Akashamulya24125/soil-moisture-sensor/Soil_Sensor_v1.csv

Reference | Qty | Value | DNP | Exclude from BOM | Exclude from Board | Exclude from Simulation | Exclude from Position Files | Footprint | Datasheet
C1 | 1 | 1nF |  |  |  |  | ${EXCLUDE_FROM_POS_FILES} | Capacitor_SMD:C_0805_2012Metric
C2,C4 | 2 | 100nF |  |  |  |  | ${EXCLUDE_FROM_POS_FILES} | Capacitor_SMD:C_0805_2012Metric
C3 | 1 | 10nF |  |  |  |  | ${EXCLUDE_FROM_POS_FILES} | Capacitor_SMD:C_0805_2012Metric
D1 | 1 | 1N4148 |  |  |  |  | ${EXCLUDE_FROM_POS_FILES} | Diode_SMD:D_SOD-123 | https://assets.nexperia.com/documents/data-sheet/1N4148_1N4448.pdf
J1 | 1 | Conn_01x03 |  |  |  |  | ${EXCLUDE_FROM_POS_FILES} | Connector_PinHeader_2.54mm:PinHeader_1x03_P2.54mm_Vertical
R1 | 1 | 1kΩ |  |  |  |  | ${EXCLUDE_FROM_POS_FILES} | Resistor_SMD:R_0805_2012Metric
R2,R3 | 2 | 10kΩ |  |  |  |  | ${EXCLUDE_FROM_POS_FILES} | Resistor_SMD:R_0805_2012Metric
R4 | 1 | 100kΩ |  |  |  |  | ${EXCLUDE_FROM_POS_FILES} | Resistor_SMD:R_0805_2012Metric
U1 | 1 | NE555P |  |  |  |  | ${EXCLUDE_FROM_POS_FILES} | Package_DIP:DIP-8_W7.62mm | http://www.ti.com/lit/ds/symlink/ne555.pdf
