Akashamulya24125/soil-moisture-sensor/plots/Soil_Sensor_v1__Assembly.pdf

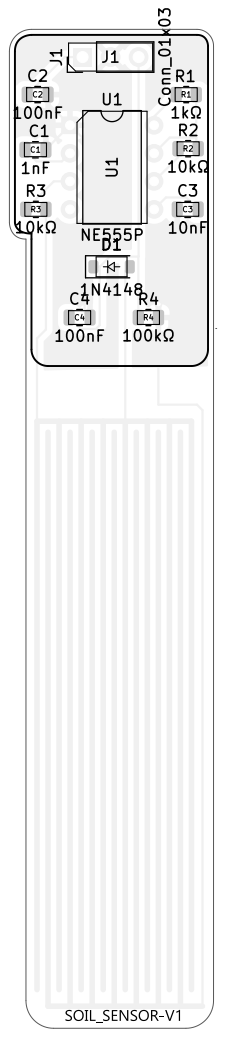
[picture p1: page 1]

Board2Pdf: Black And White TOP - Page 1/8

Sheet: Black And White TOP
File: Soil_Sensor_v1.kicad_pcb
Title:
KiCad E.D.A. 10.0.6

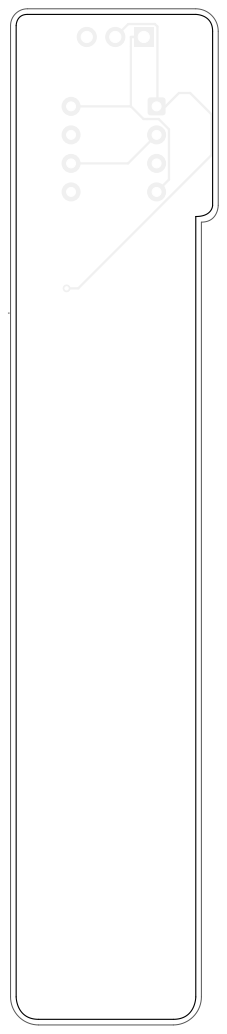
[picture p2: page 2]
D Date:

Board2Pdf: Black And White BOT - Page 2/8

Sheet: Black And White BOT
File: Soil_Sensor_v1.kicad_pcb
Title:

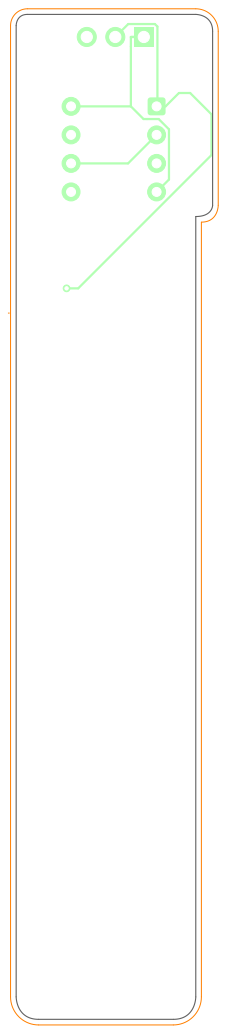
[picture p3: page 3]
D Date:

Board2Pdf: Colored BOT - Page 3/8

Sheet: Colored BOT
File: Soil_Sensor_v1.kicad_pcb
Title:

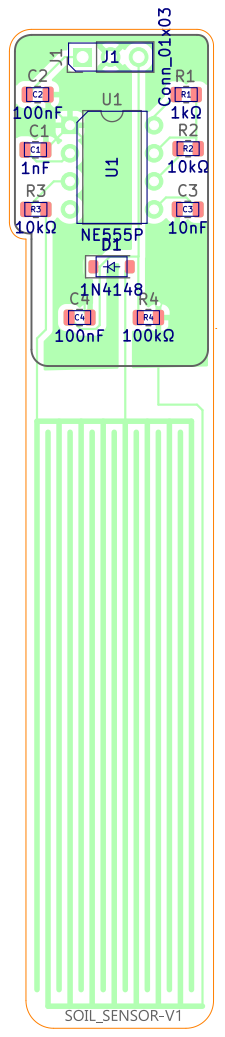
[picture p4: page 4]

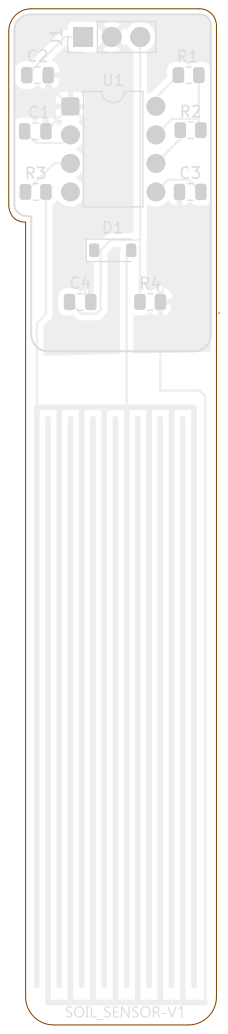
[picture p5: page 5]

Board2Pdf: Light Colors PCB Fabrication TOP - Page 5/8

Sheet: Light Colors PCB Fabrication TOP
File: Soil_Sensor_v1.kicad_pcb
Title:

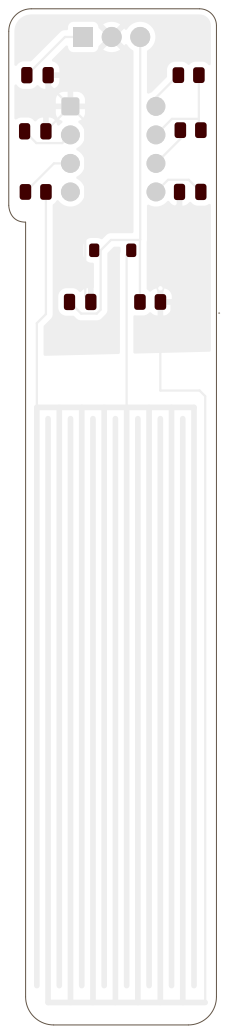
[picture p6: page 6]
D Date:

Board2Pdf: Light Colors PCB Paste TOP - Page 6/8

Sheet: Light Colors PCB Paste TOP
File: Soil_Sensor_v1.kicad_pcb
Title:

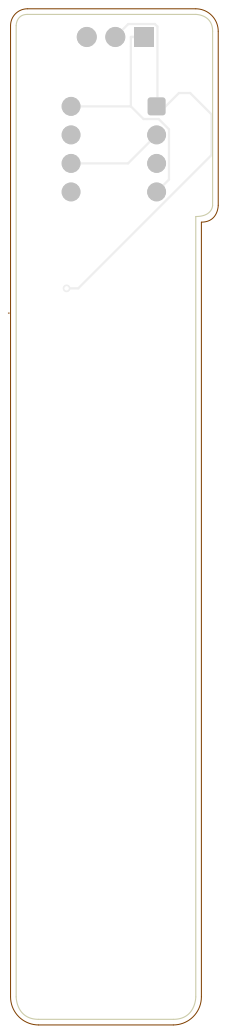
[picture p7: page 7]
D Date:

Board2Pdf: Light Colors Placement BOT - Page 7/8

Sheet: Light Colors Placement BOT
File: Soil_Sensor_v1.kicad_pcb
Title:

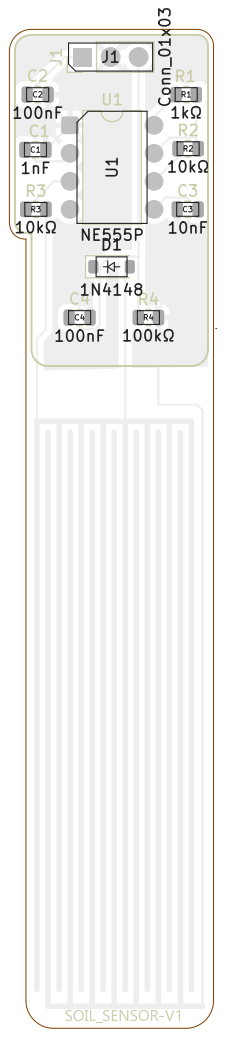
[picture p8: page 8]

Board2Pdf: Light Colors Placement TOP - Page 8/8

Sheet: Light Colors Placement TOP
File: Soil_Sensor_v1.kicad_pcb
Title:
