Akashamulya24125/soil-moisture-sensor/Soil_Sensor_v1.kicad_pcb

## KiCad design Soil_Sensor_v1.kicad_pcb (2026-10-20)

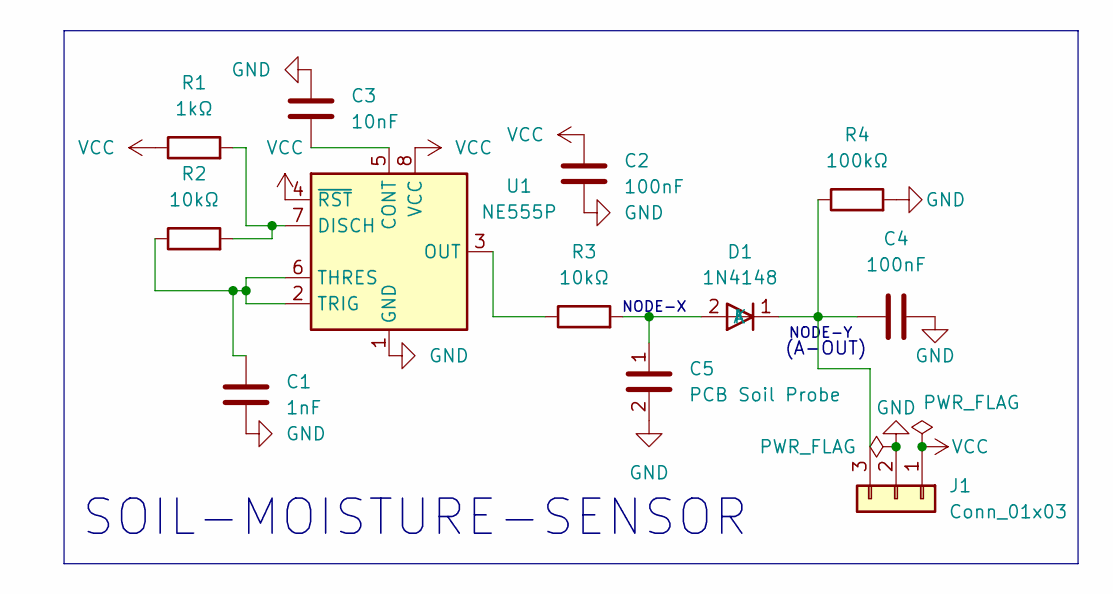
[picture p9: schematic Soil_Sensor_v1.kicad_sch, SOIL-SENSOR-VERSION-1]

Parts:
C1: 1nF; C_0805_2012Metric
C2, C4: 100nF; C_0805_2012Metric
C3: 10nF; C_0805_2012Metric
C5: PCB Soil Probe
D1: 1N4148; D_SOD-123
J1: Conn_01x03; PinHeader_1x03_P2.54mm_Vertical
R1: 1kΩ; R_0805_2012Metric
R2, R3: 10kΩ; R_0805_2012Metric
R4: 100kΩ; R_0805_2012Metric
U1: NE555P; DIP-8_W7.62mm

Connections:
GND: C1.2, C2.2, C3.1, C4.2, C5.2, J1.2, R4.2, U1.1 (GND)
unnamed: C5.1, D1.2 (A), R3.2
unnamed: C4.1, D1.1 (K), J1.3, R4.1
unnamed: C3.2, U1.5 (CONT)
unnamed: R1.2, R2.2, U1.7 (DISCH)
unnamed: R3.1, U1.3 (OUT)
unnamed: C1.1, R2.1, U1.2 (TRIG), U1.6 (THRES)
VCC: C2.1, J1.1, R1.1, U1.4 (~RST), U1.8 (VCC)

Notes on the sheet:
NODE-X
NODE-Y
(A-OUT)
SOIL-MOISTURE-SENSOR

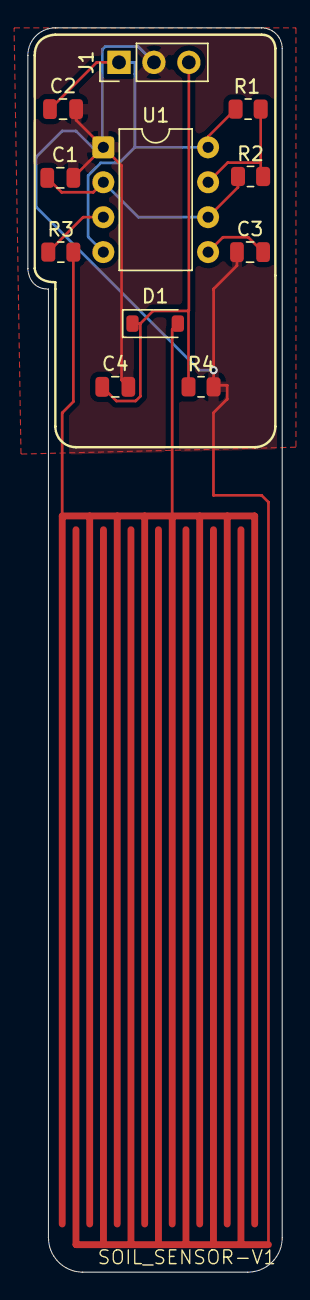
[picture p10: board Soil_Sensor_v1.kicad_pcb from above]

Board: 2 copper layers, 18.5 x 90.5 mm, 11 parts (0 on the bottom side), 8 nets.
