Akashamulya24125/soil-moisture-sensor/(commit log)

2026-10-20 Initial commit:Soil sensor V1 Kicad project
    [Soil_Moisture_Sensor_SIM.kicad_sch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]
2026-10-20 Added README for sOIL sENSOR V1
